EA5IOT/EA5IOT_GPSDO/assets/Presentacion.jpg

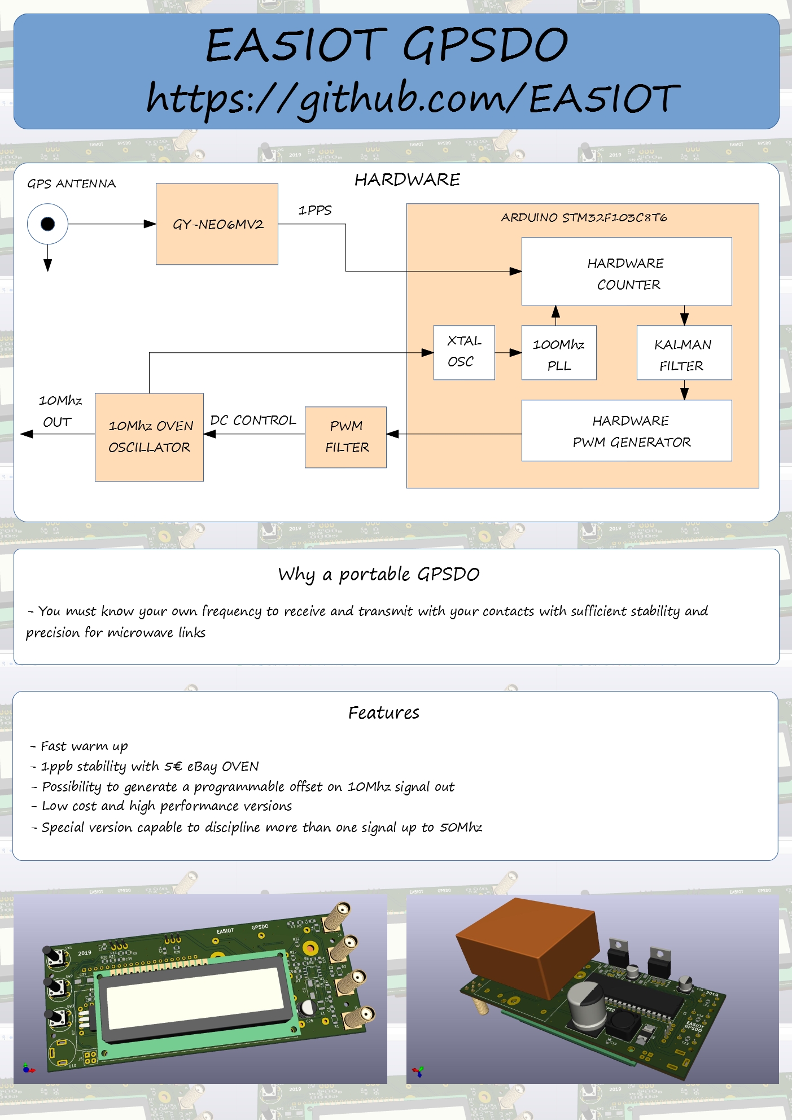
assets/Presentacion.jpg
