EA5IOT/EA5IOT_GPSDO/EA4BFK/LPF_10MHZ_V2/LPF_10MHz_V2_3DView_1.png

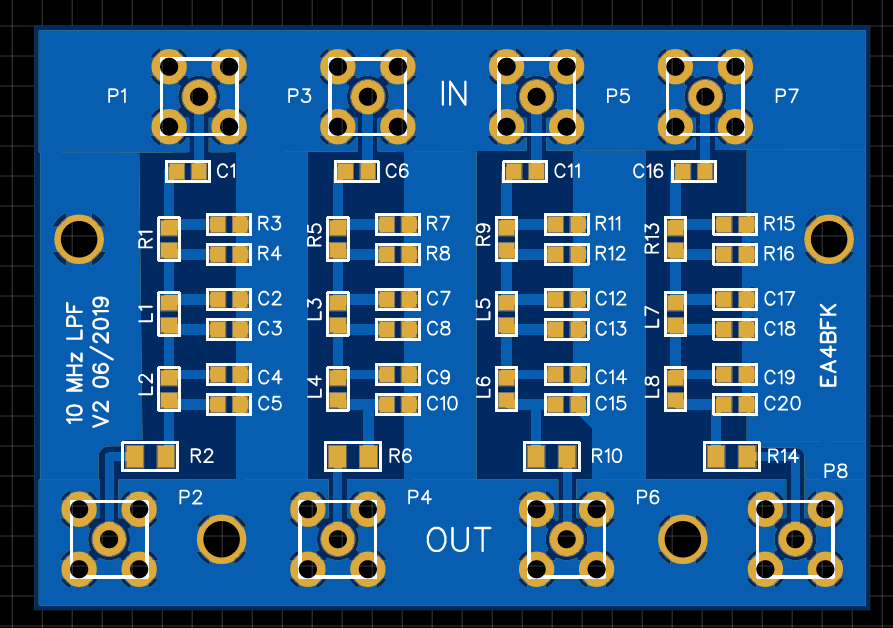
EA4BFK/LPF_10MHZ_V2/LPF_10MHz_V2_3DView_1.png
