EA5IOT/EA5IOT_GPSDO/Version Mini/OCXO/CTI_OSC5A-Specs.png

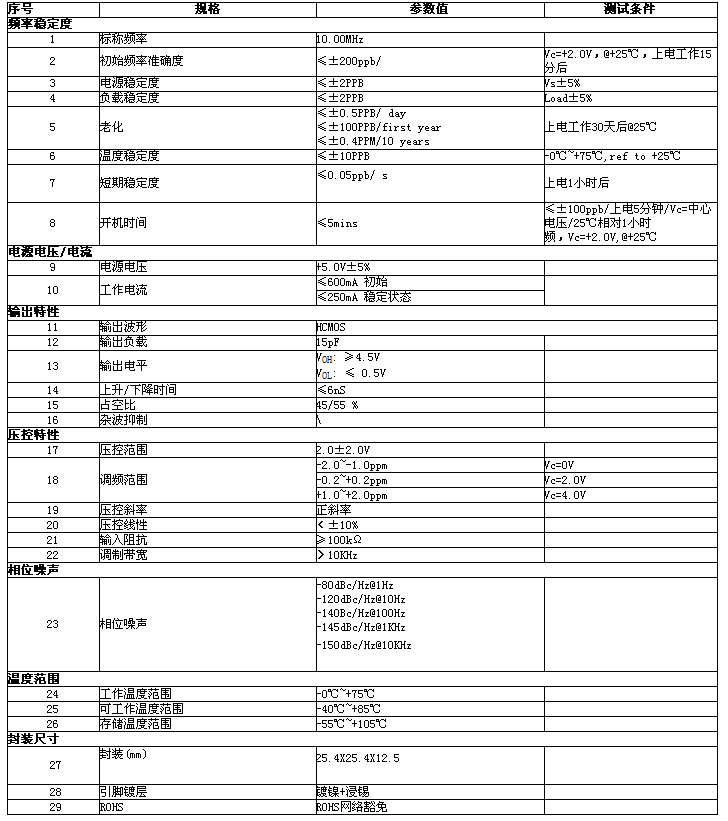
Version Mini/OCXO/CTI_OSC5A-Specs.png
