EA5IOT/EA5IOT_GPSDO/Version Mini/OCXO/CTI_OSC5A.jpg

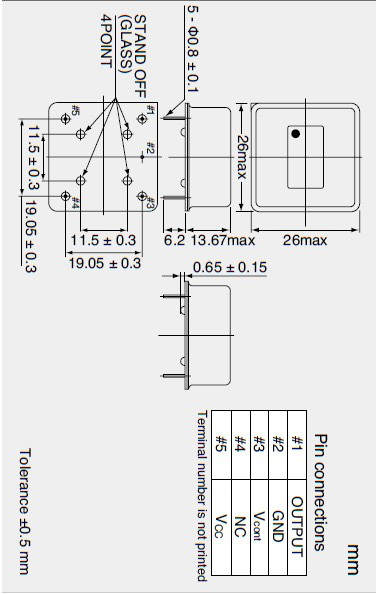
Version Mini/OCXO/CTI_OSC5A.jpg
