EA5IOT/EA5IOT_GPSDO/EA4BFK/LPF_10MHZ_V2/BOM_LPF 10MHz_20190619230246.xlsx

Referencia | Valor | Footprint | Quantity | Referencia Digikey | Descripción DigiKey
C2,C5,C7,C10,C12,C15,C17,C20 | 330pF | SMD-0805 | 8 | 732-7855-1-ND | CAP CER 330PF 50V C0G/NP0 0805
C3,C8,C13,C18 | 470pF | SMD-0805 | 4 | 732-7824-1-ND | CAP CER 470PF 16V C0G/NP0 0805
C4,C9,C14,C19 | 47pF | SMD-0805 | 4 | 732-7831-1-ND | CAP CER 47PF 25V C0G/NP0 0805
C1,C6,C11,C16 | 100nF | SMD-0805 | 4 | 732-8080-1-ND | CAP CER 0.1UF 50V X7R 0805
L1,L2,L3,L4,L5,L6,L7,L8 | 820nH | SMD-0805 | 8 | 490-5677-1-ND | FIXED IND 820NH 180MA 2.35 OHM
R2,R6,R10,R14 | 50R | SMD-1206 | 4 | CR1206-FX-49R9ELFCT-ND | RES SMD 49.9 OHM 1% 1/4W 1206
P2,P4,P6,P8 | OUT | SMA-Female | 4 | Proveedor AlliExpress según necesidades de instalacion
P1,P3,P5,P7 | IN | SMA-Female | 4 | Proveedor AlliExpress según necesidades de instalacion
R1,R5,R9,R13 | 0R *** | SMD-0805 | 4 | A decidir según sea el atenuador necesario
R4,R3,R8,R7,R12,R11,R16,R15 | *** | SMD-0805 | 8 | A decidir según sea el atenuador necesario
*** Las resitencias R1 a R5 SON RESITENCISA DE 0 OHMS, SI NO SE DESEA ATENUAR LA SALIDA
SI FUERA NECESARIA ATENUAR LA SALIDA, CALCULAR EL VALOR DEL ATENIADOR T Y MONTAR
EN CADA LPF LAS RESITENCIAS CORRESPONDIENTES
