EA5IOT/EA5IOT_GPSDO/Test PCB/GPSDO-LCD-2/BOM/BOM_EA5IOT_GPSDO_3.ods

CANTIDAD | COMPONENTE | DESCRIPCION | TIENDA | REFERENCIA | PRECIO €
1 | U1 | OPA692 | MOUSER | 595-OPA692ID | 3,22
2 | U2-U5 | LM1084-ADJ | MOUSER | 926-LM1084IT-ADJNOPB | 2,26
1 | U3 | Arduino_STM32F103C8T6 | eBay/Aliexpress | - | 1,5
1 | U4 | OPA189 | MOUSER | 595-OPA189IDBVR | 2,24
1 | U6 | LCD | eBay/Aliexpress | - | -
1 | U7 | GPS NEO 6M | eBay/Aliexpress | GY-NEO6MV2 | 3
1 | U8-U9 | OCXO | eBay/Aliexpress | STP2145A 40€ o CTI 5€ | 40 o 5
1 | L2 | 100mH 4A | MOUSER | 652-SRR1280A-101M | 0,987
2 | L1-L3 | 100uH 290mA | MOUSER | 652-SRN3015-101M | 0,279
4 | R1-R2-R3-R4 | 50 ohm – 400mW | MOUSER | 71-TNPW120650R0BEEN | 0,821
4 | R5-R6-R7-R8 | 2k2 – 0,5% | MOUSER | 754-RR1220P-222D | 0,087
2 | R9-R22 | 365 ohm – 0,5% | MOUSER | 754-RR1220P-3650D-M | 0,087
2 | R11-R25 | 121 ohm – 0,5% | MOUSER | 754-RR1220P-1210D-M | 0,087
1 | R23 | 1K04 – 0,5% | MOUSER | 660-RN732ATTD1041D25 | 0,181
2 | R24-R17 | 1K – 0,5% | MOUSER | 754-RR1220P-102D | 0,087
4 | R18-R19-R20-R21 | 470 ohm – 0,5% | MOUSER | 754-RR1220P-471D | 0,087
1 | R16 | 1M – 0,5% | MOUSER | 754-RR1220P-105D | 0,087
1 | R12 | 560 ohm – 0,5% | MOUSER | 754-RR1220P-561D | 0,087
4 | R10-R15-R20-R30 | 10K – 0,5% | MOUSER | 754-RR1220P-103D | 0,087
1 | R13 | 100K – 0,5% | MOUSER | 754-RR1220P-104D | 0,087
1 | R14 | 169K – 0,5% | MOUSER | 754-RR1220P-1693D-M | 0,087
1 | R28 | 3K9 – 0,5% | MOUSER | 754-RR1220P-392D | 0,087
1 | R31 | 1K56 – 0,5% | MOUSER | 754-RR1220P-152D | 0,087
4 | R26-R27-R32 | Opcional
5 | C11-C12-C13-C38-C39 | 1nF | MOUSER | 710-885012207086 | 0,08
15 | C1-C2-C3-C4-C5-C6-C7-C8-C10-C16-C17-C24-C27-C30-C34 | 100nF | MOUSER | 710-885012207098 | 0,06
1 | C18 | 2200uF – LOW ESR | MOUSER | 667-EEV-TG1C222UM | 1,93
3 | C19-C25-C33 | 100uF – LOW EST | MOUSER | 661-EMZJ250A101MF80G | 0,594
2 | C20-C22 | 10uF – Ceramico | MOUSER | 81-GRM21BC81C106KE5L | 0,262
7 | C14-C23-C26-C28-C29-C31-C35 | 100pF | MOUSER | 77-VJ0805A101GXJCBC | 0,253
6 | C9-C15-C21-C32-C36-C37 | 10uF- Tantalo | MOUSER | 80-T491C106M25AT7280 | 0,428
1 | D1 | Diodo 4A | MOUSER | 863-MURS480ET3G | 0,751
3 | SW1-SW2-SW3 | Pulsador 17mm | eBay/Aliexpress | - | -
3 | Capuchon pulsador | Capuchon pulsador | eBay/Aliexpress | - | -
4 | J1-J2-J3-J4 | Conector SMA PCB | eBay/Aliexpress | - | -
1 | U10 | Jack-DC | eBay/Aliexpress | - | -
