EA5IOT/EA5IOT_GPSDO/EA4BFK/LPF_10MHZ_V2/Gerber_4X10MHZ-LPF_ROUTED_20190619231147/How-to-order-PCB.txt

How to Order PCB

Please refer to:
https://docs.easyeda.com/en/PCB/Order-PCB
