EA5IOT/EA5IOT_GPSDO/Test PCB/700px-STM32_Blue_Pill_bottom[1].jpg

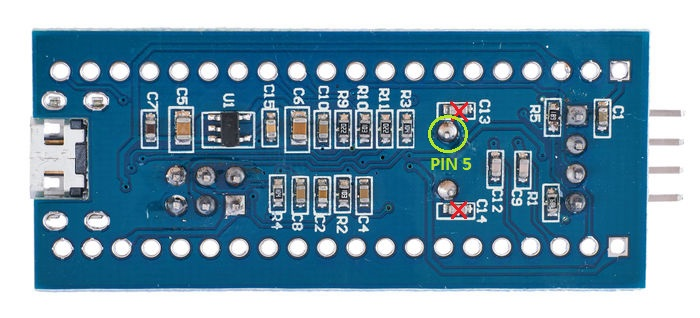
Test PCB/700px-STM32_Blue_Pill_bottom[1].jpg
