EA5IOT/EA5IOT_GPSDO/Test PCB/Vista frontal.jpg

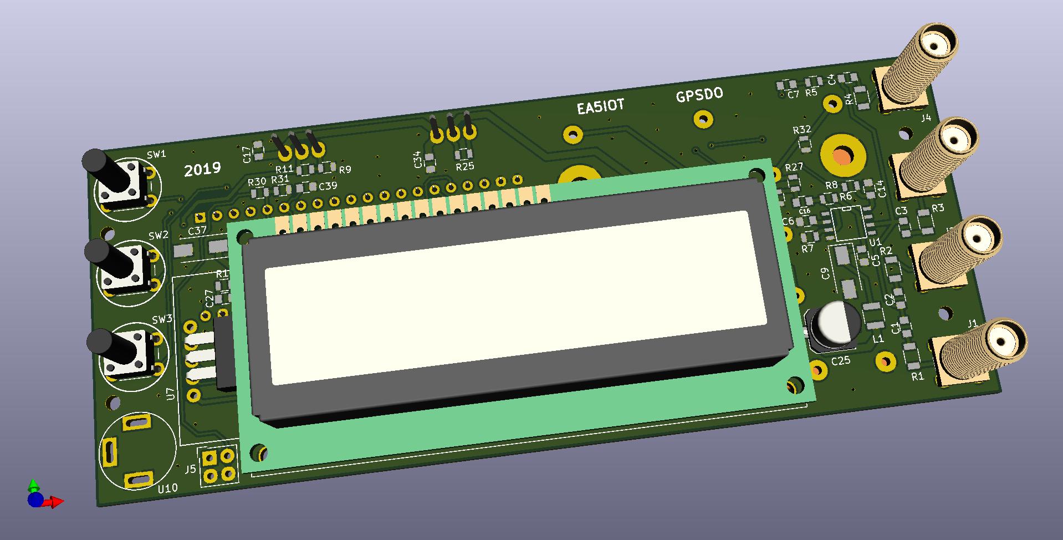
Test PCB/Vista frontal.jpg
