EA5IOT/EA5IOT_GPSDO/Test PCB/Vista trasera.jpg

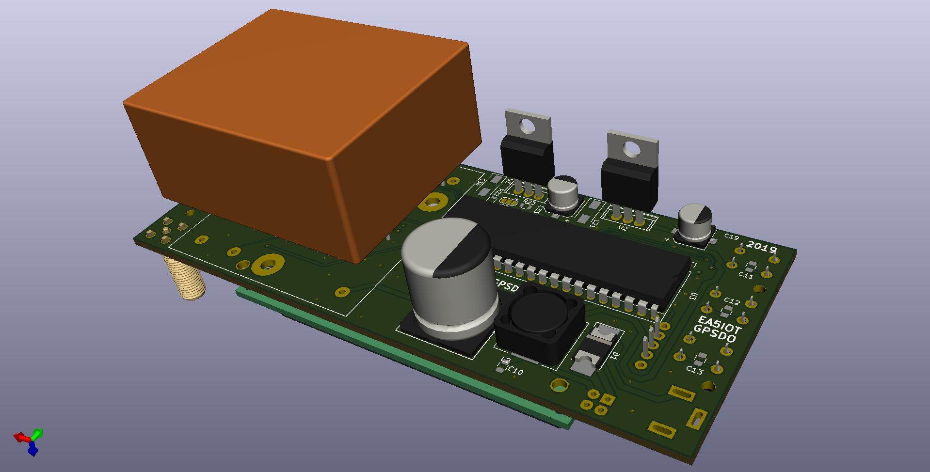
Test PCB/Vista trasera.jpg
