EA5IOT/EA5IOT_GPSDO/Test PCB/GPSDO-LCD-2/EA5IOT GPSDO-3.pdf

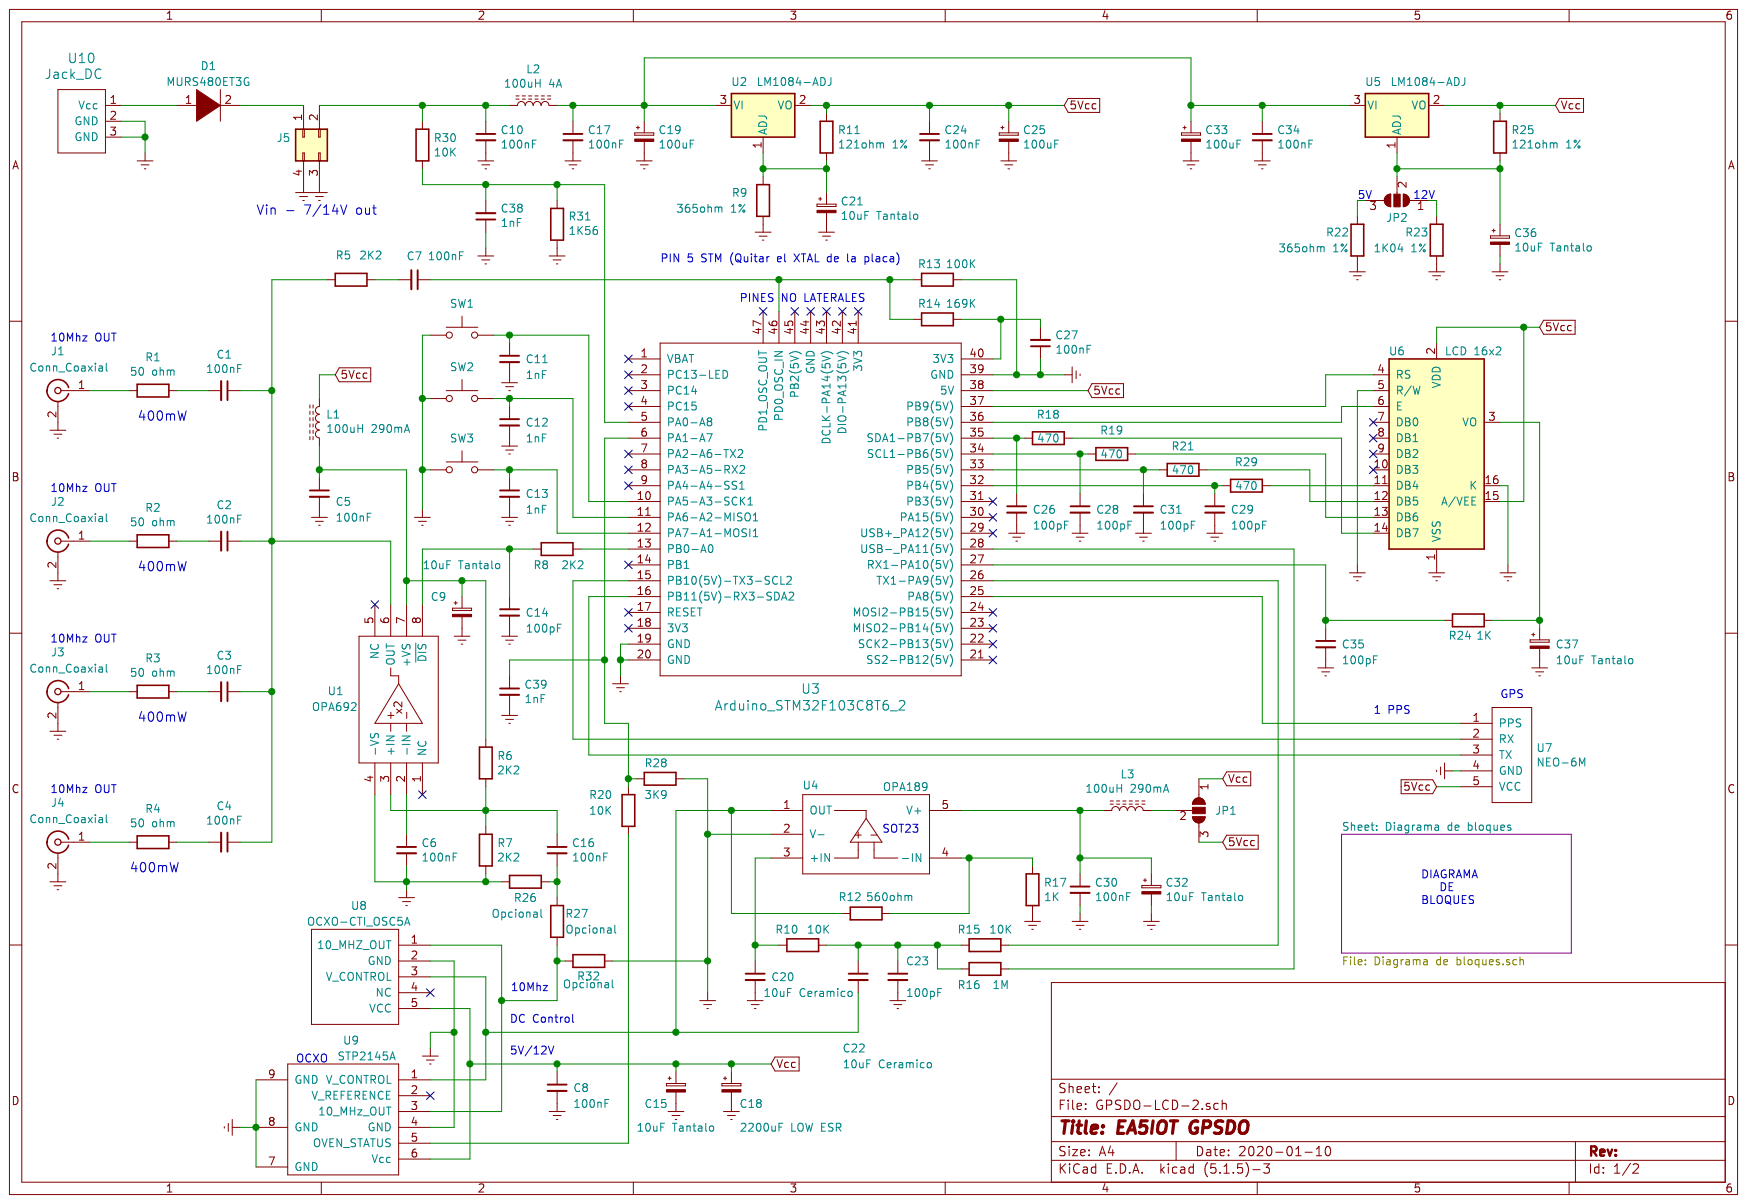
[picture p14: page 1]

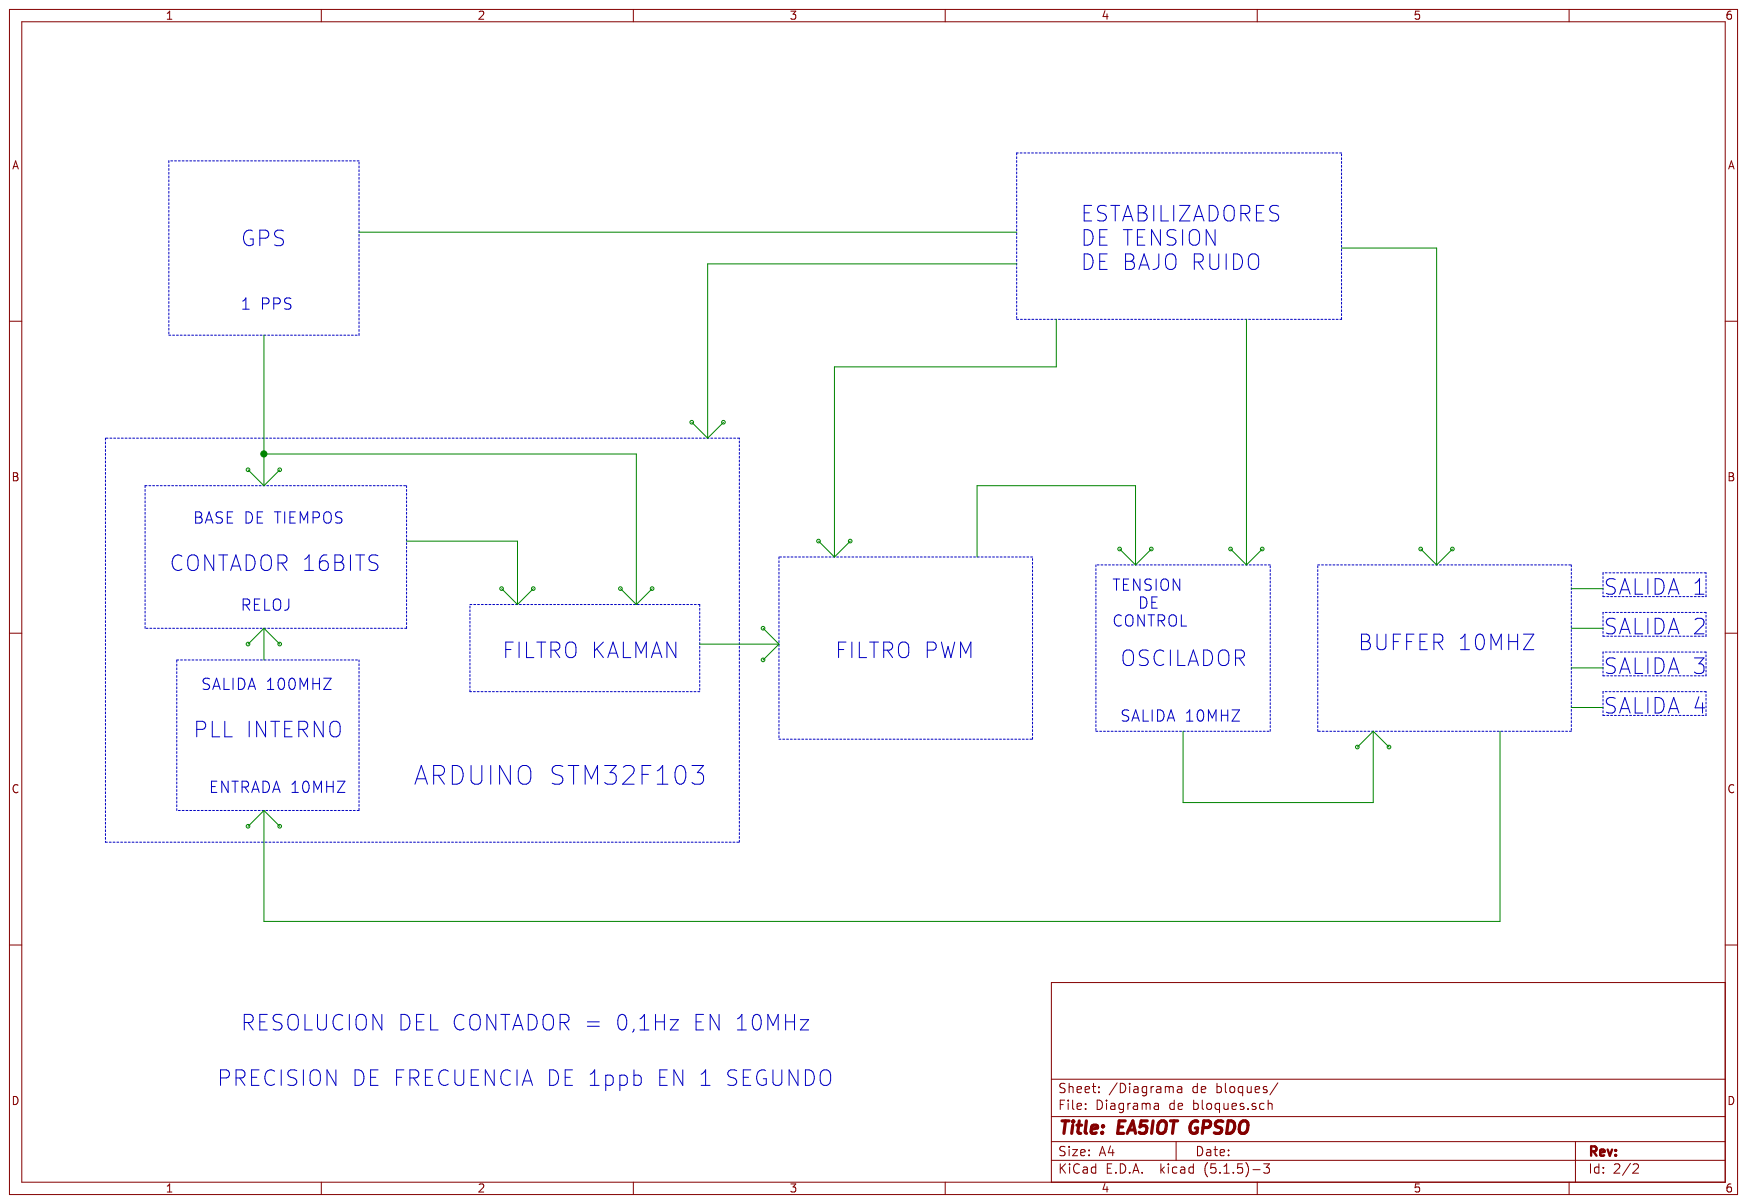
[picture p15: page 2]
