EA5IOT/EA5IOT_GPSDO/EA4BFK/LPF_10MHZ_V2/Schematic_LPF-10MHz_Sheet-1_20190619230555.pdf

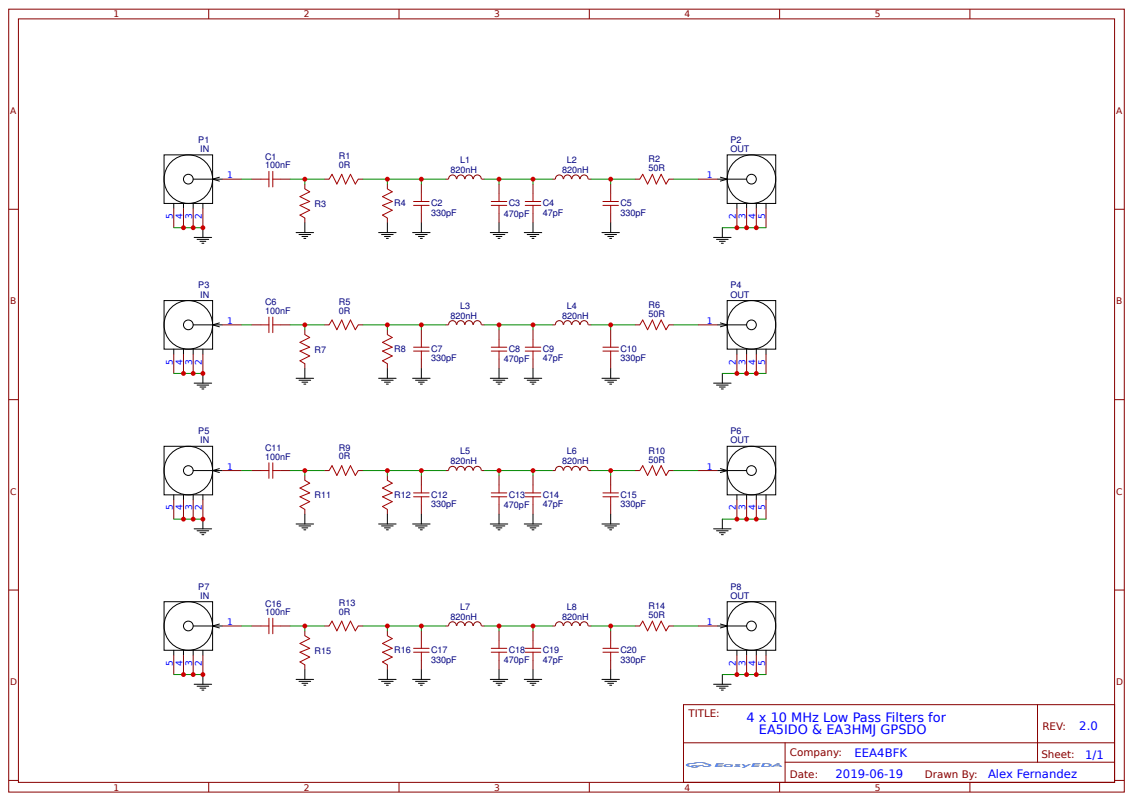
[picture p16: page 1]

Drawn By: Alex Fernandez
