EA5IOT/EA5IOT_GPSDO/Version Doble XTAL-VCXO/Hardware/GPSDO-DOBLE/GPSDO-DOBLE.pdf

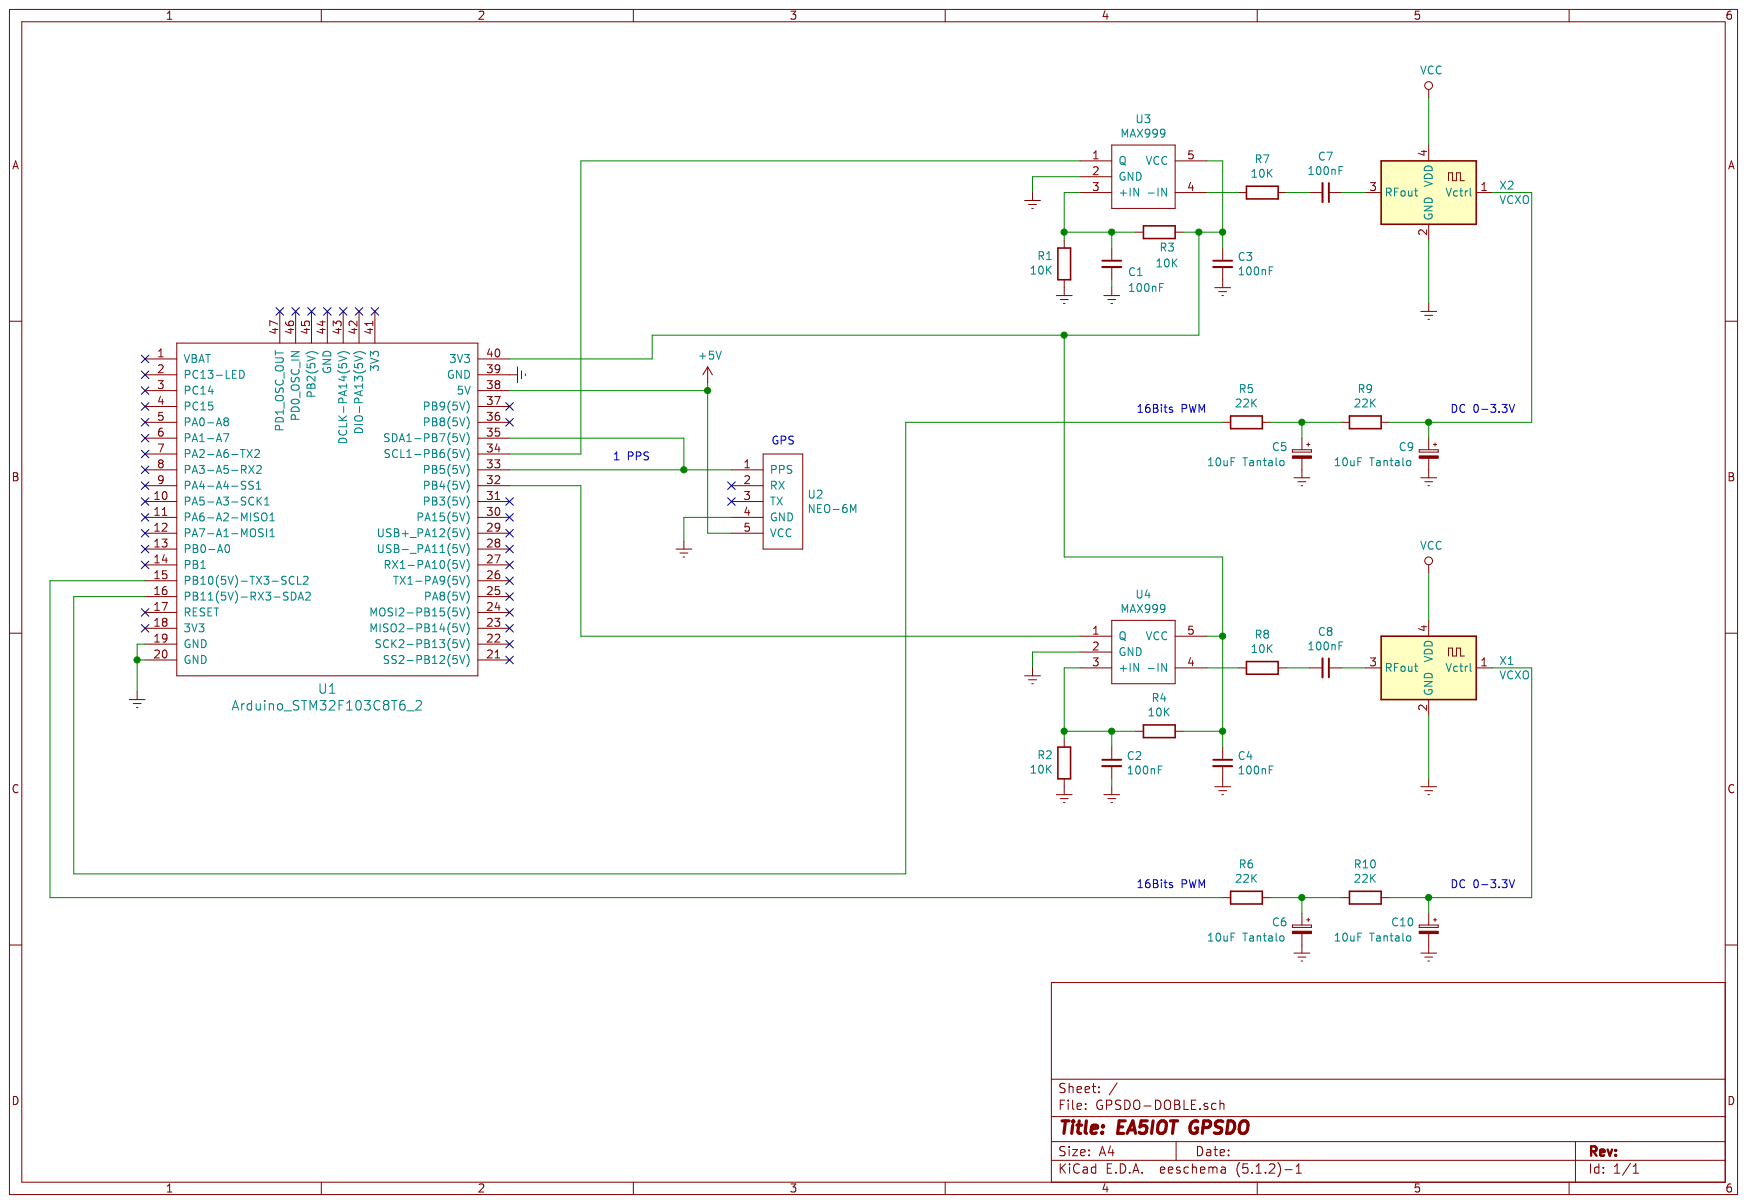
[picture p17: page 1]
