EA5IOT/EA5IOT_GPSDO/Version Mini/Hardware/GPSDO-LCD/EA5IOT GPSDO.pdf

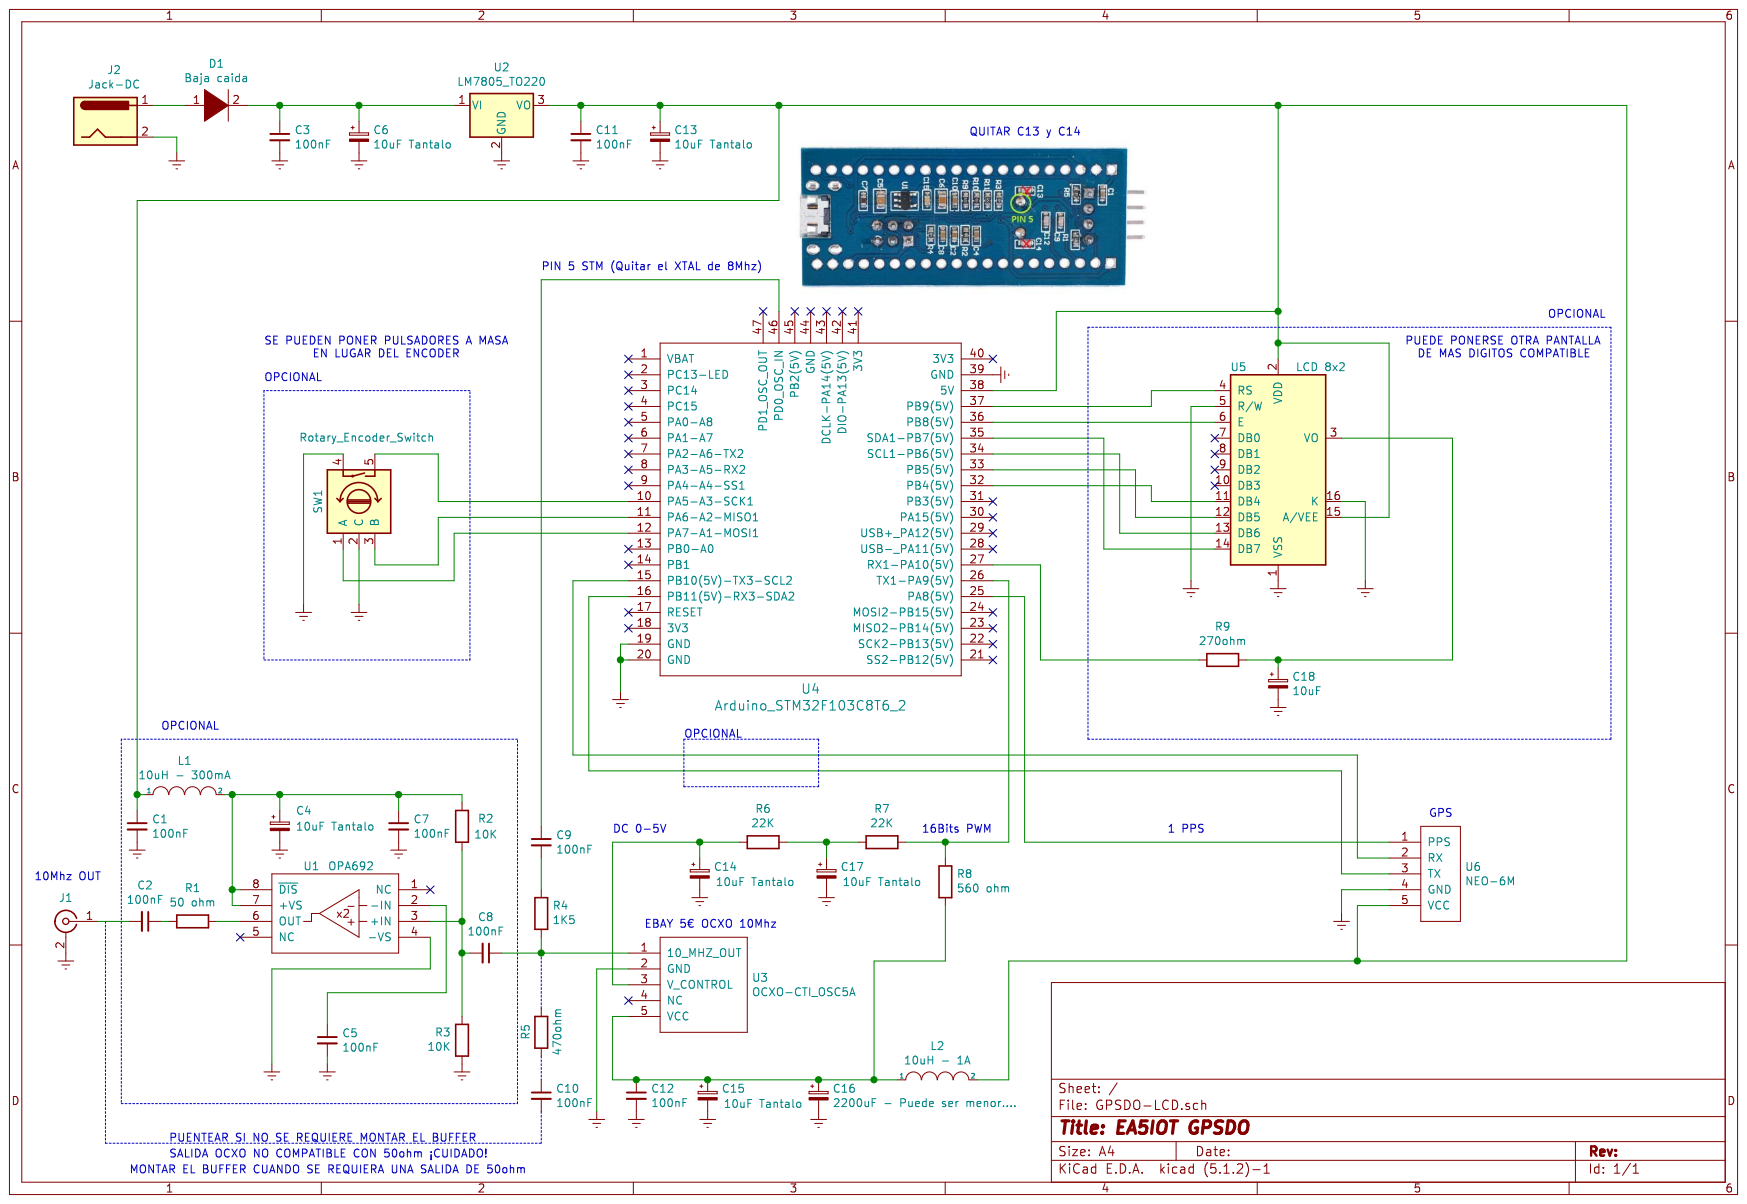
[picture p18: page 1]
