EA5IOT/EA5IOT_GPSDO/(commit log)

2019-04-28 EA5IOT_GPSDO
    EA5IOT_GPSDO
    [BOM_EA5IOT_GPSDO_2.ods, Diagrama de bloques.sch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]
2019-06-19 Update
    Update
    [Diagrama de bloques.sch, GPSDO-LCD-2.sch]
2019-06-21 LPF_10MHZ_V2
    LPF_10MHZ_V2
    [BOM_LPF 10MHz_20190619230246.xlsx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]
2019-09-10 Correccion pin CLK MCU
    Correccion pin CLK MCU
2019-09-29 Version Mini
    Version Mini
    [GPSDO-LCD.kicad_pcb, GPSDO-LCD.sch]
2019-10-10 Version Doble
    Version Doble
    [GPSDO-DOBLE.kicad_pcb, GPSDO-DOBLE.sch]
2020-01-10 U4 Update
    U4 Update
    [BOM_EA5IOT_GPSDO_2.ods, BOM_EA5IOT_GPSDO_3.ods]
