EA5IOT/EA5IOT_GPSDO/(notices)

Notices in the files:
Version Doble XTAL-VCXO/Firmware/GPSDO_Doble/GPSDO_Doble.ino:
This program is free software: you can redistribute it and/or modify
it under the terms of the GNU General Public License as published by
the Free Software Foundation, either version 3 of the License, or
(at your option) any later version.
